theNeonTerminal/Custom-ESP32-Dev-Board/BOM.csv

Item | Qty | Supplier | Cost/item | Total Cost | link
Professional PCB | 1 | jlcpcb.com | $14.50 | $14.50 | https://jlcpcb.com
5.1k reistor | 1 | lcscindia.com | $0.20 | $0.20 | https://www.lcsc.com/product-detail/C23186.html
470 ohm resisotr | 1 | lcscindia.com | $0.13 | $0.13 | https://www.lcsc.com/product-detail/C2907172.html
10k resistor | 1 | lcscindia.com | $0.36 | $0.36 | https://www.lcsc.com/product-detail/C98220.html
47.5k resistor | 1 | lcscindia.com | $0.43 | $0.43 | https://www.lcsc.com/product-detail/C325696.html
22.1k resistor | 1 | lcscindia.com | $0.36 | $0.36 | https://www.lcsc.com/product-detail/C2960862.html
10uf capacitor | 1 | lcscindia.com | $0.54 | $0.54 | https://www.lcsc.com/product-detail/C19702.html
4.7uf capacitor | 1 | lcscindia.com | $0.64 | $0.64 | https://www.lcsc.com/product-detail/C1705.html
22uf capacitor | 1 | lcscindia.com | $0.43 | $0.43 | https://www.lcsc.com/product-detail/C86295.html
1uf capacitor | 1 | lcscindia.com | $0.33 | $0.33 | https://www.lcsc.com/product-detail/C5199872.html
WS2812B LEDs | 1 | lcscindia.com | $2.00 | $2.00 | https://www.lcsc.com/product-detail/C4154882.html
RED LED | 1 | lcscindia.com | $0.40 | $0.40 | https://www.lcsc.com/product-detail/C965799.html
USB C port | 1 | lcscindia.com | $2.00 | $2.00 | https://www.lcsc.com/product-detail/C2765186.html
TF Card Slot | 1 | lcscindia.com | $1.00 | $1.00 | https://www.lcsc.com/product-detail/C7529389.html
SS8050 | 1 | lcscindia.com | $1.00 | $1.00 | https://www.lcsc.com/product-detail/C2926167.html
AMS1117 3V3 | 1 | lcscindia.com | $1.00 | $1.00 | https://www.lcsc.com/product-detail/C5205141.html
Push Button | 1 | lcscindia.com | $0.15 | $0.15 | https://www.lcsc.com/product-detail/C36498960.html
ESP WROOM 32D | 1 | lcscindia.com | $5.59 | $5.59 | https://www.lcsc.com/product-detail/C473012.html
Estimated total shipping | 1 |  |  | $1.90
