theNeonTerminal/Custom-ESP32-Dev-Board/Custom ESP32 Dev Board.kicad_pcb

## KiCad design Custom ESP32 Dev Board.kicad_pcb (2026-11-09)

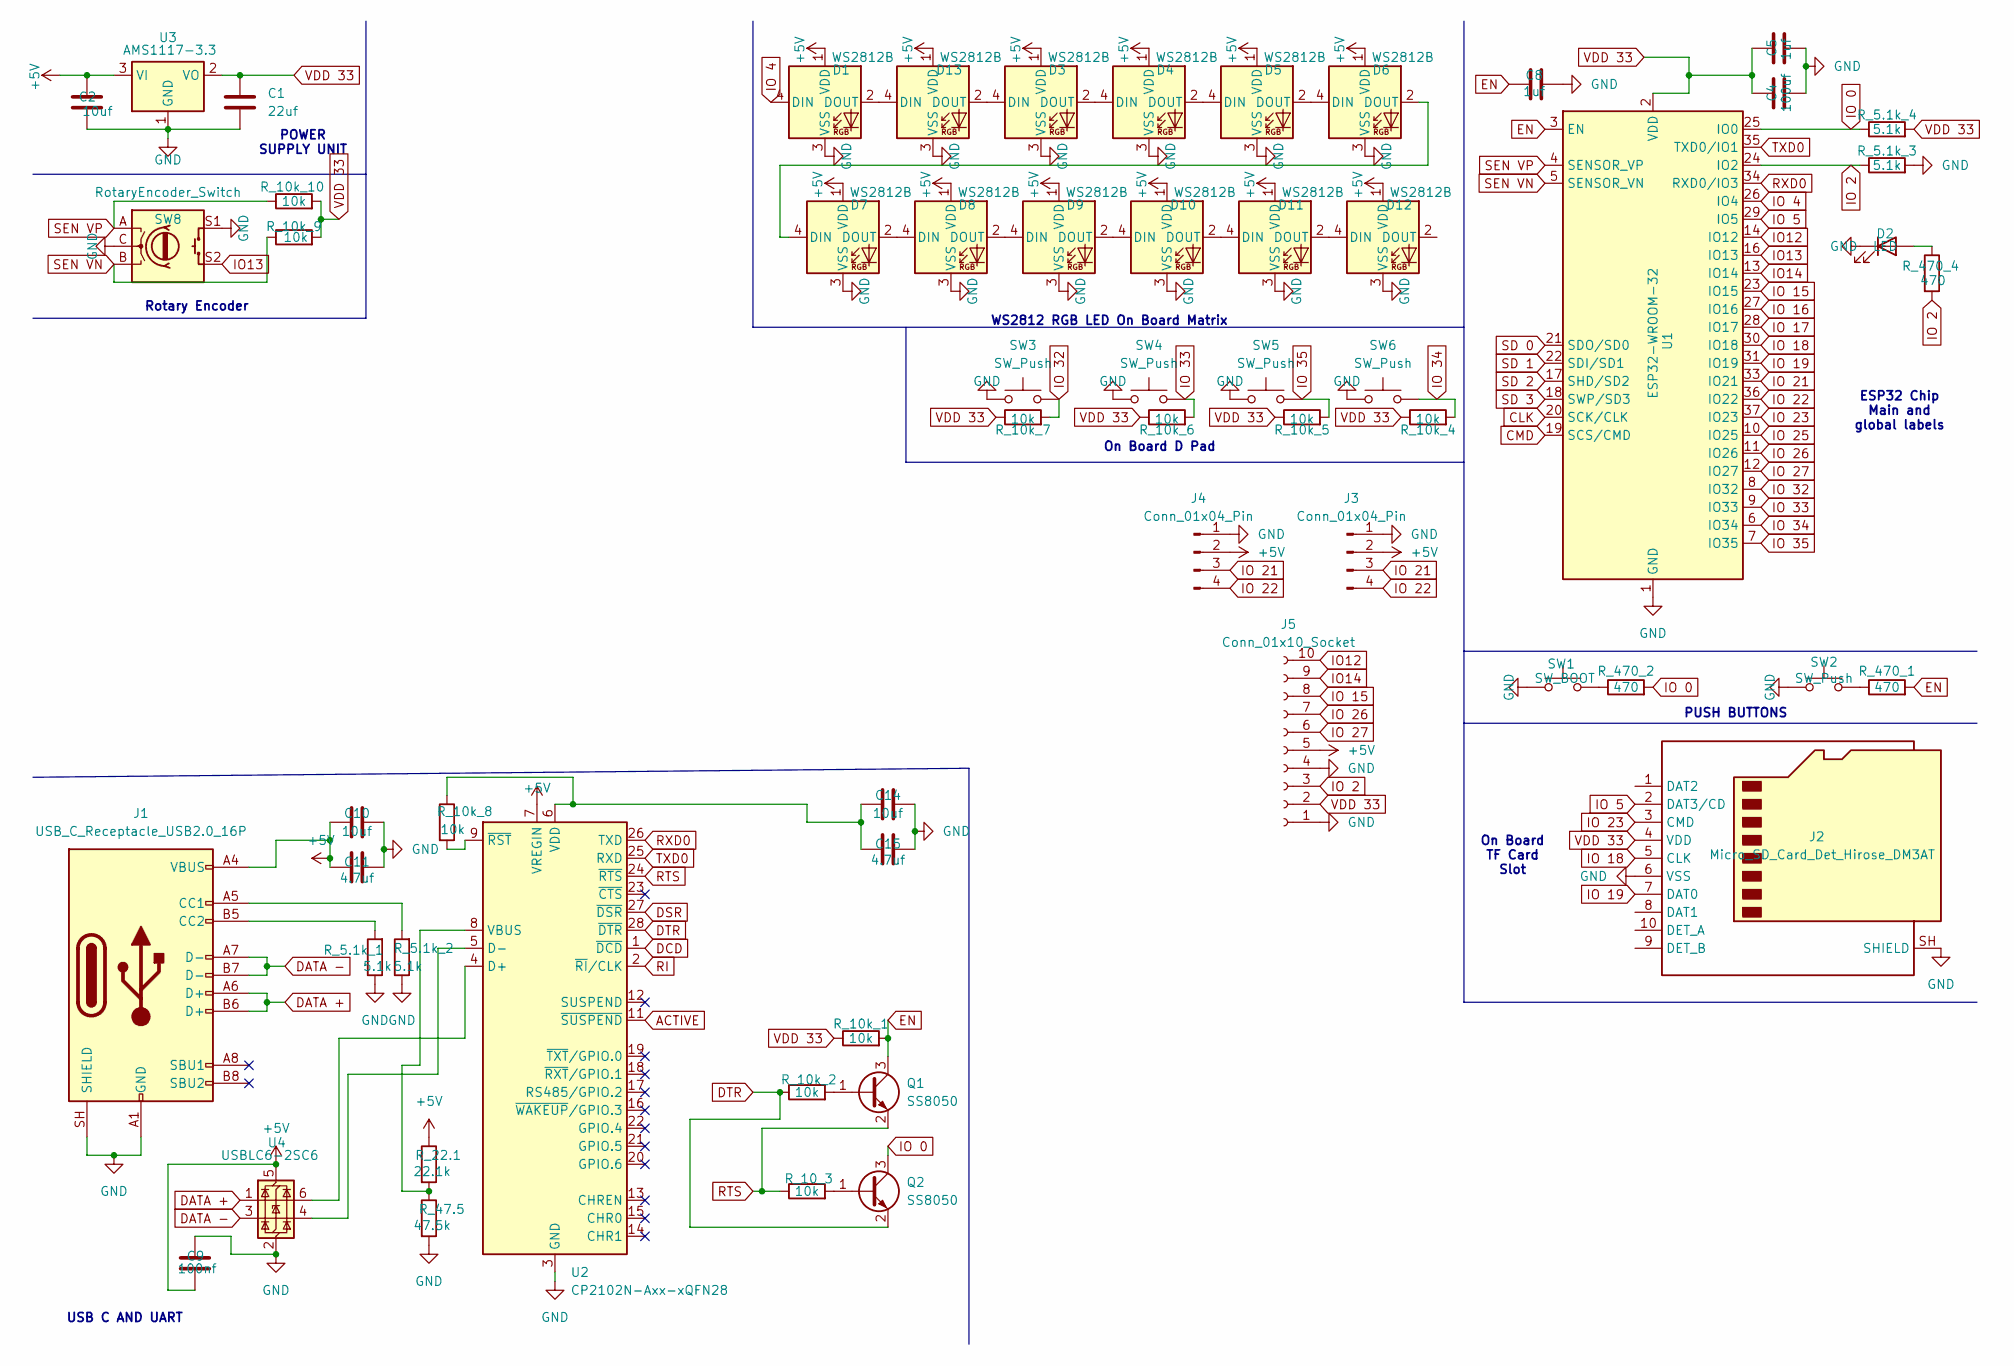
[picture p5: schematic Custom ESP32 Dev Board.kicad_sch]

Parts:
C1: 22uf; C_0603_1608Metric
C2, C10, C14: 10uf; C_0603_1608Metric
C4: 100uf; C_0603_1608Metric
C5, C8: 1uf; C_0603_1608Metric
C9: 100nf; C_0603_1608Metric
C11, C15: 4.7uf; C_0603_1608Metric
D1, D3, D4, D5, D6, D7, D8, D9, D10, D11, D12, D13: WS2812B; LED_WS2812B_PLCC4_5.0x5.0mm_P3.2mm
D2: LED; LED_0603_1608Metric
J1: USB_C_Receptacle_USB2.0_16P; USB_C_Receptacle_GCT_USB4105-xx-A_16P_TopMnt_Horizontal
J2: Micro_SD_Card_Det_Hirose_DM3AT; microSD_HC_Hirose_DM3AT-SF-PEJM5
J3, J4: Conn_01x04_Pin; PinSocket_1x04_P2.54mm_Vertical
J5: Conn_01x10_Socket; PinSocket_1x10_P2.54mm_Vertical
Q1, Q2: SS8050; SOT-23
R_5.1k_1, R_5.1k_2, R_5.1k_3, R_5.1k_4: 5.1k; R_1206_3216Metric_Pad1.30x1.75mm_HandSolder
R_10_3, R_10k_1, R_10k_2, R_10k_4, R_10k_5, R_10k_6, R_10k_7, R_10k_8, R_10k_9, R_10k_10: 10k; R_0603_1608Metric_Pad0.98x0.95mm_HandSolder
R_22.1: 22.1k; R_0603_1608Metric_Pad0.98x0.95mm_HandSolder
R_47.5: 47.5k; R_01005_0402Metric
R_470_1, R_470_2, R_470_4: 470; R_0603_1608Metric_Pad0.98x0.95mm_HandSolder
SW1: SW_BOOT; SW_Tactile_SPST_NO_Straight_CK_PTS636Sx25SMTRLFS
SW2: SW_Push; SW_Tactile_SPST_NO_Straight_CK_PTS636Sx25SMTRLFS
SW3, SW4, SW5, SW6: SW_Push; SW_PUSH_6mm
SW8: RotaryEncoder_Switch; RotaryEncoder_Alps_EC11E-Switch_Vertical_H20mm
U1: ESP32-WROOM-32
U2: CP2102N-Axx-xQFN28; QFN-28-1EP_5x5mm_P0.5mm_EP3.35x3.35mm
U3: AMS1117-3.3; SOT-223-3_TabPin2
U4: USBLC6-2SC6; SOT-23-6

Connections:
+5V: C2.1, C9.2, C10.1, C11.1, D1.1 (VDD), D3.1 (VDD), D4.1 (VDD), D5.1 (VDD), D6.1 (VDD), D7.1 (VDD), D8.1 (VDD), D9.1 (VDD), D10.1 (VDD), D11.1 (VDD), D12.1 (VDD), D13.1 (VDD), J1.A4 (VBUS), J1.A9 (VBUS), J1.B4 (VBUS), J1.B9 (VBUS), J3.2, J4.2, J5.5, R_22.1.1, U2.7 (VREGIN), U3.3 (VI), U4.5 (VBUS)
ACTIVE: U2.11 (~SUSPEND)
CLK: U1.20 (SCK/CLK)
CMD: U1.19 (SCS/CMD)
DATA +: J1.A6 (D+), J1.B6 (D+), U4.1 (I/O1)
DATA -: J1.A7 (D-), J1.B7 (D-), U4.3 (I/O2)
DCD: U2.1 (~DCD)
DSR: U2.27 (~DSR)
DTR: Q2.2 (E), R_10k_2.1, U2.28 (~DTR)
EN: C8.1, Q1.3 (C), R_10k_1.2, R_470_1.2, U1.3 (EN)
GND: C1.2, C2.2, C4.2, C5.2, C8.2, C9.1, C10.2, C11.2, C14.2, C15.2, D1.3 (VSS), D2.1 (K), D3.3 (VSS), D4.3 (VSS), D5.3 (VSS), D6.3 (VSS), D7.3 (VSS), D8.3 (VSS), D9.3 (VSS), D10.3 (VSS), D11.3 (VSS), D12.3 (VSS), D13.3 (VSS), J1.A1 (GND), J1.A12 (GND), J1.B1 (GND), J1.B12 (GND), J1.SH (SHIELD), J2.6 (VSS), J2.SH (SHIELD), J3.1, J4.1, J5.1, J5.4, R_5.1k_1.1, R_5.1k_2.1, R_5.1k_3.2, R_47.5.2, SW1.1, SW2.1, SW3.1, SW4.1, SW5.1, SW6.1, SW8.C, SW8.S1, U1.1 (GND), U1.15 (GND), U1.38 (GND), U1.39 (GND), U2.3 (GND), U2.29 (GND), U3.1 (GND), U4.2 (GND)
IO12: J5.10, U1.14 (IO12)
IO13: SW8.S2, U1.16 (IO13)
IO14: J5.9, U1.13 (IO14)
IO 0: Q2.3 (C), R_5.1k_4.1, R_470_2.2, U1.25 (IO0)
IO 2: J5.3, R_5.1k_3.1, R_470_4.2, U1.24 (IO2)
IO 4: D1.4 (DIN), U1.26 (IO4)
IO 5: J2.2 (DAT3/CD), U1.29 (IO5)
IO 15: J5.8, U1.23 (IO15)
IO 16: U1.27 (IO16)
IO 17: U1.28 (IO17)
IO 18: J2.5 (CLK), U1.30 (IO18)
IO 19: J2.7 (DAT0), U1.31 (IO19)
IO 21: J3.3, J4.3, U1.33 (IO21)
IO 22: J3.4, J4.4, U1.36 (IO22)
IO 23: J2.3 (CMD), U1.37 (IO23)
IO 25: U1.10 (IO25)
IO 26: J5.7, U1.11 (IO26)
IO 27: J5.6, U1.12 (IO27)
IO 32: R_10k_7.2, SW3.2, U1.8 (IO32)
IO 33: R_10k_6.2, SW4.2, U1.9 (IO33)
IO 34: R_10k_4.2, SW6.2, U1.6 (IO34)
IO 35: R_10k_5.2, SW5.2, U1.7 (IO35)
unnamed: D1.2 (DOUT), D13.4 (DIN)
unnamed: D2.2 (A), R_470_4.1
unnamed: D3.2 (DOUT), D4.4 (DIN)
unnamed: D4.2 (DOUT), D5.4 (DIN)
unnamed: D5.2 (DOUT), D6.4 (DIN)
unnamed: D6.2 (DOUT), D7.4 (DIN)
unnamed: D7.2 (DOUT), D8.4 (DIN)
unnamed: D8.2 (DOUT), D9.4 (DIN)
unnamed: D9.2 (DOUT), D10.4 (DIN)
unnamed: D10.2 (DOUT), D11.4 (DIN)
unnamed: D11.2 (DOUT), D12.4 (DIN)
unnamed: D3.4 (DIN), D13.2 (DOUT)
unnamed: J1.A5 (CC1), R_5.1k_2.2
unnamed: J1.B5 (CC2), R_5.1k_1.2
unnamed: Q1.1 (B), R_10k_2.2
unnamed: Q2.1 (B), R_10_3.2
unnamed: R_470_1.1, SW2.2
unnamed: R_470_2.1, SW1.2
unnamed: U2.4 (D+), U4.6 (I/O1)
unnamed: U2.5 (D-), U4.4 (I/O2)
unnamed: R_22.1.2, R_47.5.1, U2.8 (VBUS)
unnamed: C14.1, C15.1, R_10k_8.1, U2.6 (VDD)
unnamed: R_10k_8.2, U2.9 (~RST)
RI: U2.2 (~RI/CLK)
RTS: Q1.2 (E), R_10_3.1, U2.24 (~RTS)
RXD0: U1.34 (RXD0/IO3), U2.26 (TXD)
SD 0: U1.21 (SDO/SD0)
SD 1: U1.22 (SDI/SD1)
SD 2: U1.17 (SHD/SD2)
SD 3: U1.18 (SWP/SD3)
SEN VN: R_10k_9.1, SW8.B, U1.5 (SENSOR_VN)
SEN VP: R_10k_10.1, SW8.A, U1.4 (SENSOR_VP)
TXD0: U1.35 (TXD0/IO1), U2.25 (RXD)
VDD 33: C1.1, C4.1, C5.1, J2.4 (VDD), J5.2, R_5.1k_4.2, R_10k_1.1, R_10k_4.1, R_10k_5.1, R_10k_6.1, R_10k_7.1, R_10k_9.2, R_10k_10.2, U1.2 (VDD), U3.2 (VO)

Notes on the sheet:
On Board D Pad
Rotary Encoder
PUSH BUTTONS
On Board TF Card Slot
USB C AND UART
WS2812 RGB LED On Board Matrix
POWER SUPPLY UNIT
ESP32 Chip Main and global labels

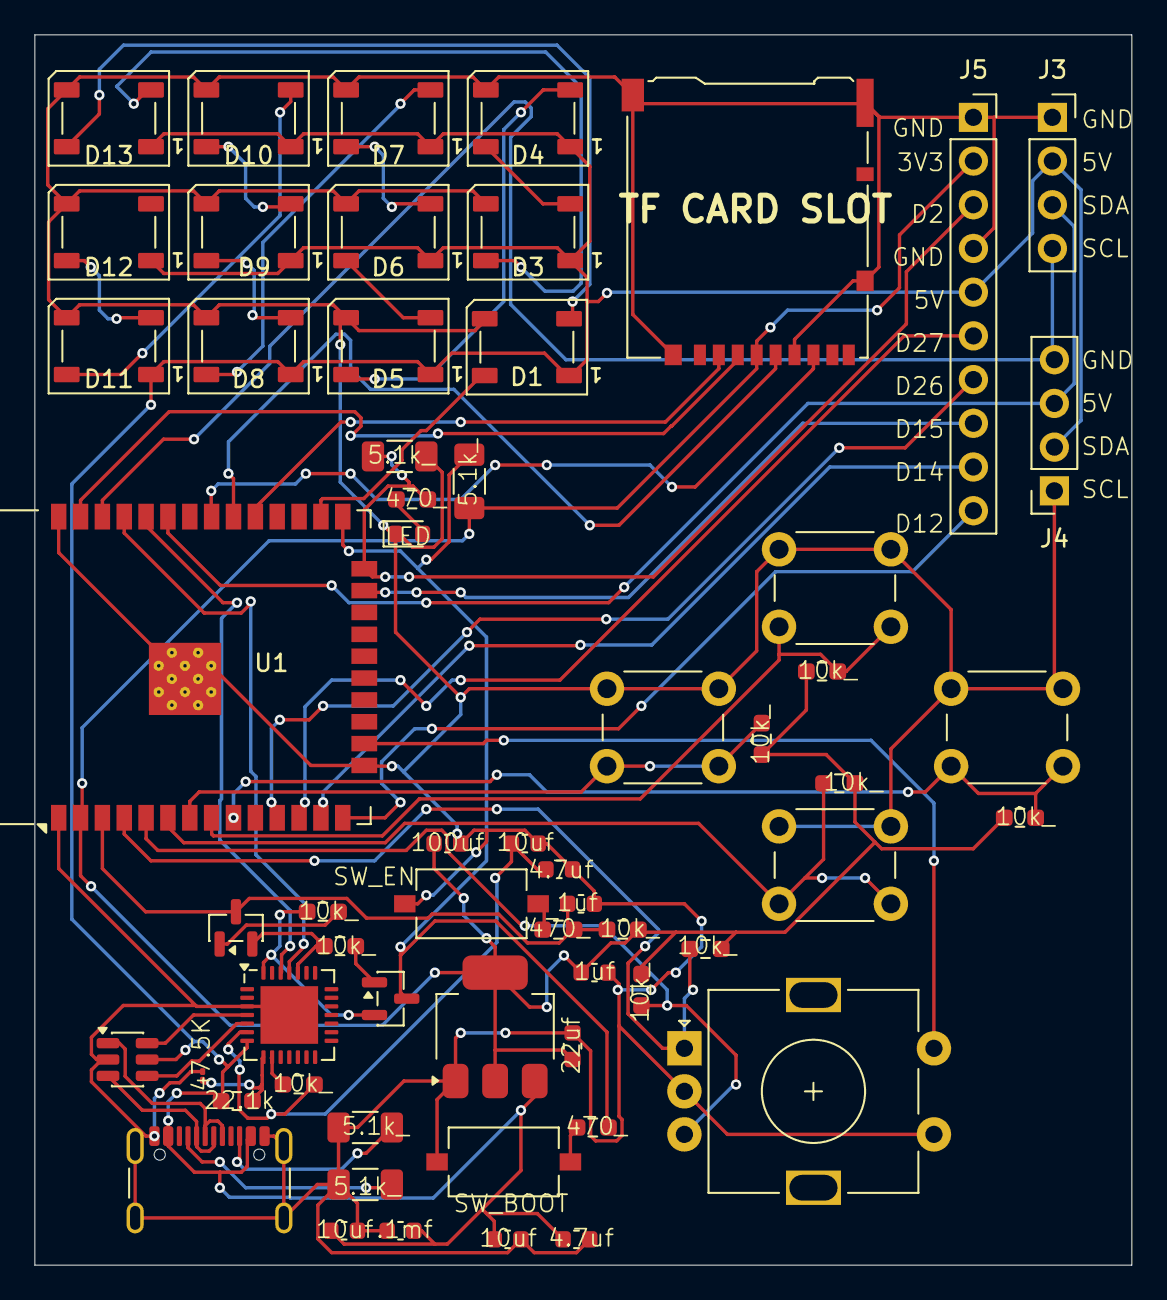
[picture p6: board Custom ESP32 Dev Board.kicad_pcb from above]

Board: 2 copper layers, 63.8 x 71.5 mm, 60 parts (0 on the bottom side), 54 nets.
