theNeonTerminal/Custom-ESP32-Dev-Board/JOURNAL.md

# Custom ESP32 Dev board: devlog

<!-- Generated by Half Life from project i5vz8g1r82grvked9ujre475. Edits here are overwritten on the next sync. -->
<!-- Generated: 2026-11-09T02:18:26.602Z -->

> [!NOTE]
> This devlog is mirrored from [Half Life](https://halflife.hackclub.com) ([open the project](https://halflife.hackclub.com/projects/i5vz8g1r82grvked9ujre475)). Editing it here will not change the platform's copy, and the next sync overwrites this file.

> A custom ESP32 dev board, where everything is based around raw ICs and SMD Components. My first time stepping into making dev baords

| Week | Tier | Hours logged | Entries |
| --- | --- | --- | --- |
| Week 5 | Tier 1 | 14h | 5 |

## Contents

1. [2026-11-04: ](#2026-11-04-imagehttpshalflifehackclub-assetscomsessionssg2yt)
2. [2026-11-07: Completed the schematic, took longer than expected, mostly becuase I was too afraid to even start routing the PCB for the CP2102N might be incorrectly connected](#2026-11-07-completed-the-schematic-took-longer-than-expected)
3. [2026-11-07: Took a little longer than expeted, SMD routing is harder than THT routing, for you cant start a via on 1 layer and end it on another, not my fault](#2026-11-07-took-a-little-longer-than-expeted-smd-routing-is-)
4. [2026-11-08: UGHHHH, FIXING DRC TOOK SOOOO LONG :(](#2026-11-08-ughhhh-fixing-drc-took-soooo-long)
5. [2026-11-08: ](#2026-11-08-imagehttpshalflifehackclub-assetscomsessionssg2yt)

## Design

### 2026-11-04: 

**2h**





Made a fair amount of progress in making my 1st custom esp32 dev board
Things completed today:
- ESP32 chip and pin connections
- UART and USB Type C connections
- PSU

Things still pending:
- ERC checks
- assigning footprints and annotating schematics
- PCB and routes
- assigning footprints
- some extra stuff (a tb6612 FNG motor driver, few RGB leds (WS28212B) and an SD card slot)

### 2026-11-07: Completed the schematic, took longer than expected, mostly becuase I was too afraid to even start routing the PCB for the CP2102N might be incorrectly connected

**4h**

Completed the schematic, took longer than expected, mostly becuase I was too afraid to even start routing the PCB for the CP2102N might be incorrectly connected
Things I did:
- Verified all ERC checks
- Sourced all components (for many of them, they have a large min order quantity, something I cant chose)
- fixed AMS1117 5v to 3.3v (it was an accident)
- Added USB Surge proctection, few more decoupling caps and auto programming circuit
- Added Custom modules: 12 WS2812B RGB LEDs, 4 push buttons, 1 rotary encoder

Now I will start with teh PCB routing part









### 2026-11-07: Took a little longer than expeted, SMD routing is harder than THT routing, for you cant start a via on 1 layer and end it on another, not my fault

**3h**

Took a little longer than expeted, SMD routing is harder than THT routing, for you cant start a via on 1 layer and end it on another, not my fault

Things I did:
- assigned footprints and sourced all components
- routed a lot of the PCB







Now I will fix all DRC errors (my god there are like 150 of them) - will take some time
Route rest of the PCB (buttons and rotary encoder)
Add Connectors for the unused pins
Add silkscreen lables

A lot to complete

[Timelapse](https://lookout.hackclub.com/api/media/1525fe49-692e-401d-aa11-b597129c3407/video.mp4)

### 2026-11-08: UGHHHH, FIXING DRC TOOK SOOOO LONG :(

**3h**

UGHHHH, FIXING DRC TOOK SOOOO LONG :(
I fixed all DRC errors (took a little longer than expected), completed rest of the routing (buttons and rotary encoder) and thats pretty much it for this session.
Now I will add some finishing touches: Connectors for unused pins, README, push to github, etc
Should take likr 1.5hr (hopefully)







### 2026-11-08: 

**2h**



3d1

Fully completed the project: Added finishing touches: including a good README, connectors for the extra/unused pins, 2x I2C connectors (far right the 1x4 female header pins)
Board passes most of the DRC errors, but many silkscreen overlaps the pad, cant do much about it for I placed them very very close to each other
