theNeonTerminal/Custom-ESP32-Dev-Board/(commit log)

2026-11-02 Sync Custom ESP32 Dev board from Half Life
    [BOM.csv]
2026-11-04 Did a lot of work on the board
    [Custom ESP32 Dev Board.kicad_pcb, Custom ESP32 Dev Board.kicad_sch]
2026-11-06 Made some changes to schematic
    [Custom ESP32 Dev Board.kicad_pcb, Custom ESP32 Dev Board.kicad_sch]
2026-11-07 (Msotly) completed schematic
    [Custom ESP32 Dev Board.kicad_sch]
2026-11-09 Completed routing
    [Custom ESP32 Dev Board.kicad_pcb, Custom ESP32 Dev Board.kicad_sch]
2026-11-09 Added README
    [Custom ESP32 Dev Board-B_Cu.gbr, Custom ESP32 Dev Board-B_Mask.gbr, Custom ESP32 Dev Board-B_Paste.gbr, Custom ESP32 Dev Board-B_Silkscreen.gbr, Custom ESP32 Dev Board-Edge_Cuts.gbr, Custom ESP32 Dev Board-F_Cu.gbr, Custom ESP32 Dev Board-F_Mask.gbr, Custom ESP32 Dev Board-F_Paste.gbr]
